GQster/miataWink/SmartSelect_20251212-212220_Squid.jpg

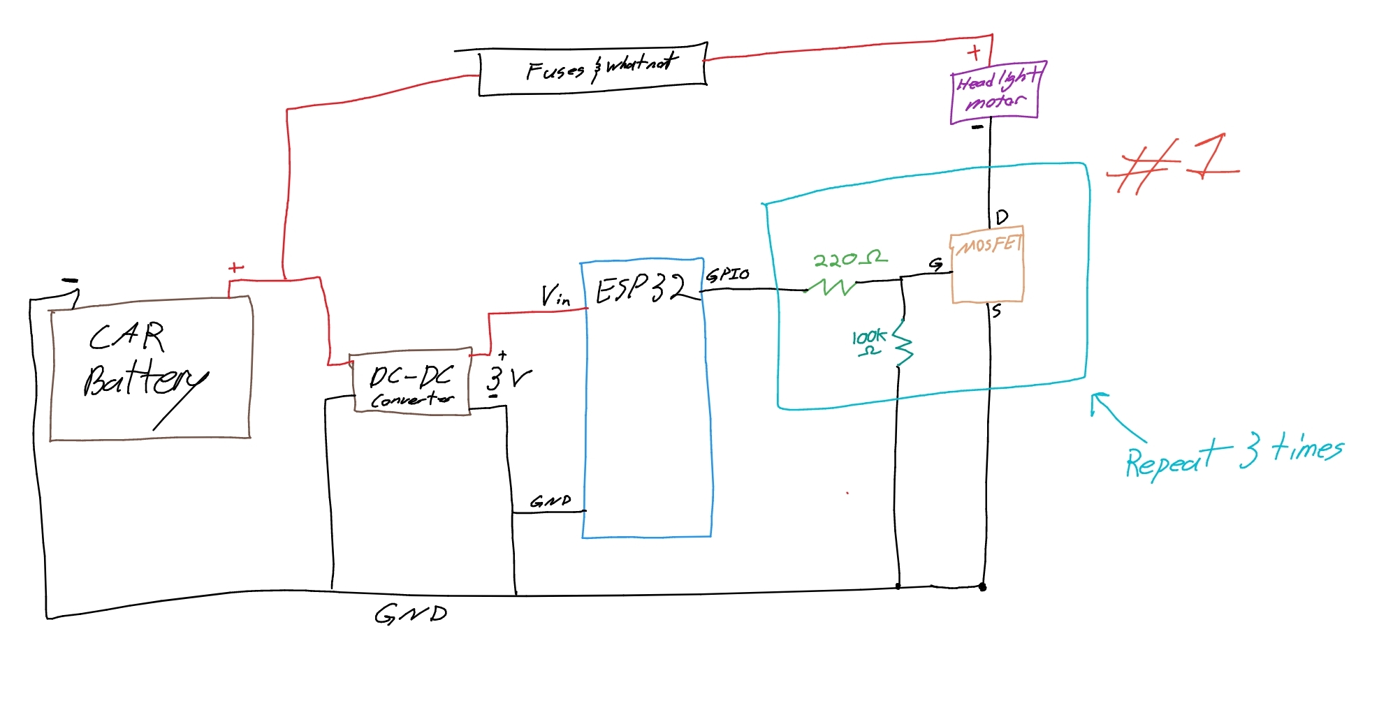
SmartSelect_20251212-212220_Squid.jpg
